schattenstrategie-collab/meridron-catalog-demo/pkg/00_START_HERE.pdf

## MERIDRON · BLUEPRINT CATALOG

# START HERE · D1b TRAINER

## REV 1 · 25 Oct 2026 · DESIGN CHECKED · FIRST FLIGHT PENDING

# THE FOUR STEPS (SAME FOR EVERY DRONE)

1
WATCH | 07_Video: the explainer, once, before you touch anything.
2 DOWNLOAD | You have it: this ZIP with seven folders.
3 BUILD | 05_Build_Guide: 14 steps, one page each, a check at the end of every step.
4 CHECK | Last page of the build guide: tick every box before the first flight.

# WHAT IS IN EACH FOLDER

Folder | What it is | Size
01_Cutting | Foam templates: 1:1 PDF on A4 + DXF for CNC/hot wire | 167 kB
02_Print | 16 STL files + print list. Print each file as often as its name says. | 1.6 MB
03_Wiring | Wiring diagram: battery, ESC, motor, receiver, 2 servos | 35 kB
04_Firmware_Radio | No flight controller on the D1b: radio setup sheet (channels, throws, failsafe) | 110 kB
05_Build_Guide | 14 steps with pictures, time and a pass check for each step | 1.6 MB
06_Parts_List | Everything to buy, with quantities and CHF prices | 2 kB
07_Video | Explainer video (works without sound) | 5.1 MB

# NAMES

Every file starts with the drone and revision: D1b_Rev1_…. Print files end with how often to print them: …_print-5x.stl = print 5.

## STATUS AND LICENCE

Calculated, not yet flown. Rev 1 becomes 'Flight proven' after the first build in the demonstrator workshop. Report anything that does not fit: every report makes the next revision. This package is for authorized Meridron partners only. Do not pass it on.

Meridron · D1b Trainer Rev 1 · 25 Oct 2026 · Start here | 1
