schattenstrategie-collab/meridron-catalog-demo/pkg/01_Cutting/D1b_Rev1_Templates_1to1_A4.pdf

# D1b TRAINER · FOAM TEMPLATES 1:1

1 Print this file at 100 % (actual size). Never 'fit to page'.
2 Measure the 50 mm bar on every page and the 100 mm square below.
3 Tape the pages of one part together: grey band = overlap, line up the crosses.
4 Cut the paper on the thick line. Trace it onto the foam. Dashed lines are marks, not cuts.
5 Orange = cut-outs (servo window, horn slits, dowel holes).
Part | Name | Material | Cut | Pages
F1 | Fuselage core | XPS 30 mm | 1 × | 2–4
F2 | Fuselage side wall | Depron 6 mm | 2 × | 5–7
T1 | Stabilizer + elevator | Depron 6 mm | 1 × | 8–9
T2 | Fin + rudder | Depron 6 mm | 1 × | 10
S1 | Top skin, centre | Depron 3 mm | 1 × | 11–13
S2 | Top skin, outer panel + tip | Depron 3 mm | 2 × | 14–16
S3 | Bottom skin, centre | Depron 3 mm | 1 × | 17–18
S4 | Bottom skin, outer panel | Depron 3 mm | 2 × | 19–20

100 × 100 mm
measure both sides

50 mm check: must measure exactly 50 mm

Status: Design checked · first flight pending. Calculated, not yet flown.

Meridron · D1b Trainer Rev 1 · Foam templates 1:1 · Cover | Page 1 of 20

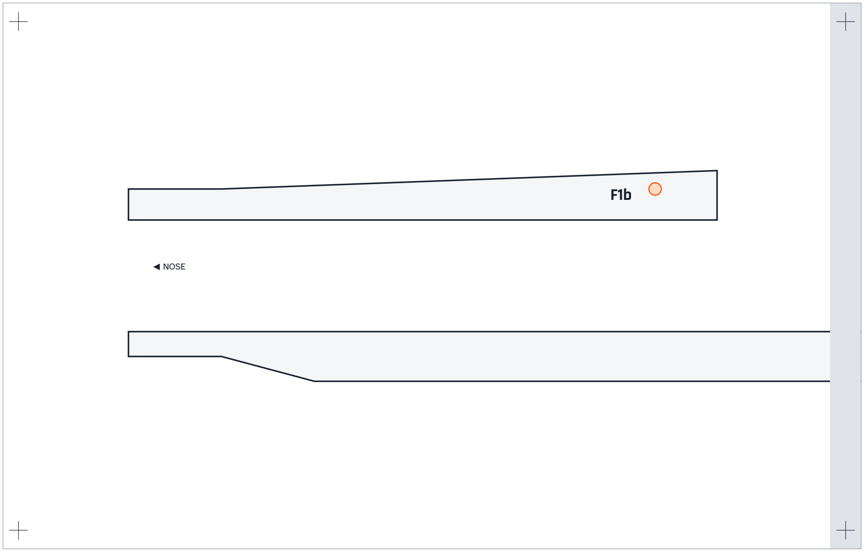
[picture p1: figure]
NOSE

50 mm check: must measure exactly 50 mm | F1 1/3 Saw outside the line · F1b = tunnel roof (separate piece)
Drill dowel holes after gluing (Ø 4)
Meridron · D1b Trainer Rev 1 · Foam templates 1:1 · F1 Fuselage core | Page 2 of 20

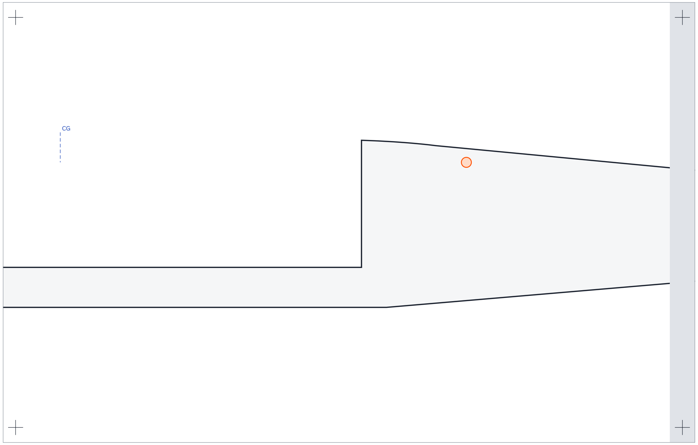
[picture p2: figure]

50 mm check: must measure exactly 50 mm | F1 2/3 Saw outside the line · F1b = tunnel roof (separate piece)
Drill dowel holes after gluing (Ø 4)
Meridron · D1b Trainer Rev 1 · Foam templates 1:1 · F1 Fuselage core | Page 3 of 20

F1a

Fuselage core · XPS 30 mm · cut 1

50 mm check: must measure exactly 50 mm | F1 3/3 Saw outside the line · F1b = tunnel roof (separate piece)
Drill dowel holes after gluing (Ø 4)
Meridron · D1b Trainer Rev 1 · Foam templates 1:1 · F1 Fuselage core | Page 4 of 20

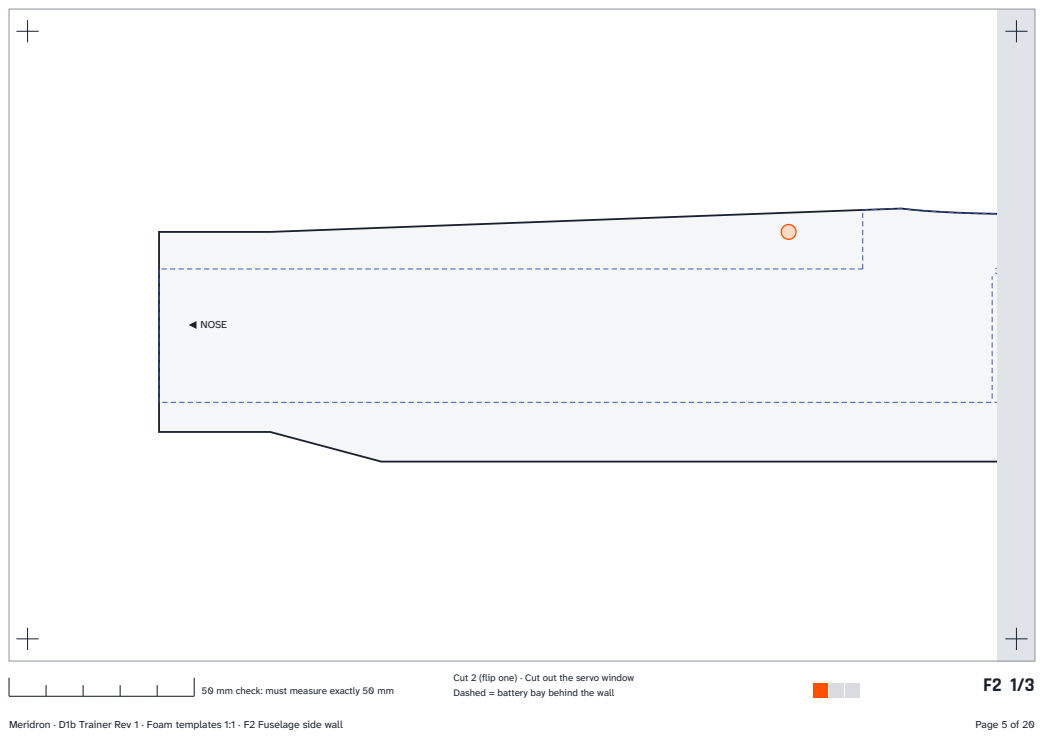
[picture p3: page 5]
3S 2200 front; NOSE; 50 mm check: must measure exactly 50 mm; F2 1/3 Cut 2 (flip one) · Cut out the servo window; Meridron · D1b Trainer Rev 1 · Foam templates 1:1 · F2 Fuselage side wall; Page 5 of 20

Dashed = battery bay behind the wall

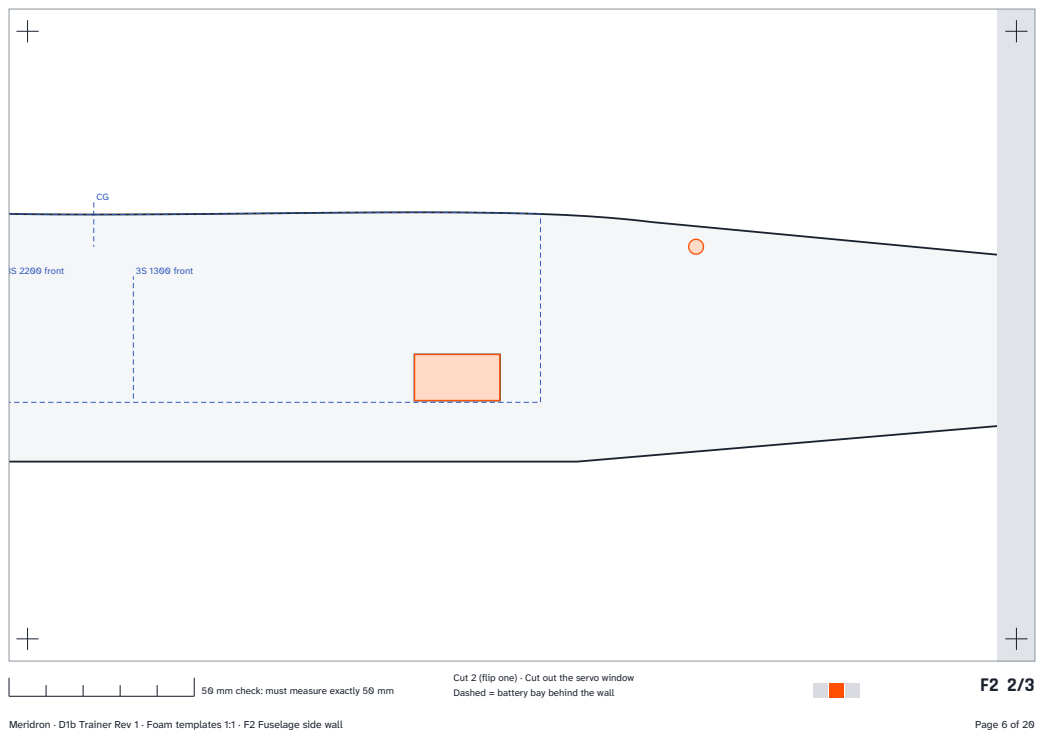
[picture p4: page 6]
3S 2200 front; 3S 1300 front; 50 mm check: must measure exactly 50 mm; F2 2/3 Cut 2 (flip one) · Cut out the servo window; Meridron · D1b Trainer Rev 1 · Foam templates 1:1 · F2 Fuselage side wall; Page 6 of 20

Dashed = battery bay behind the wall

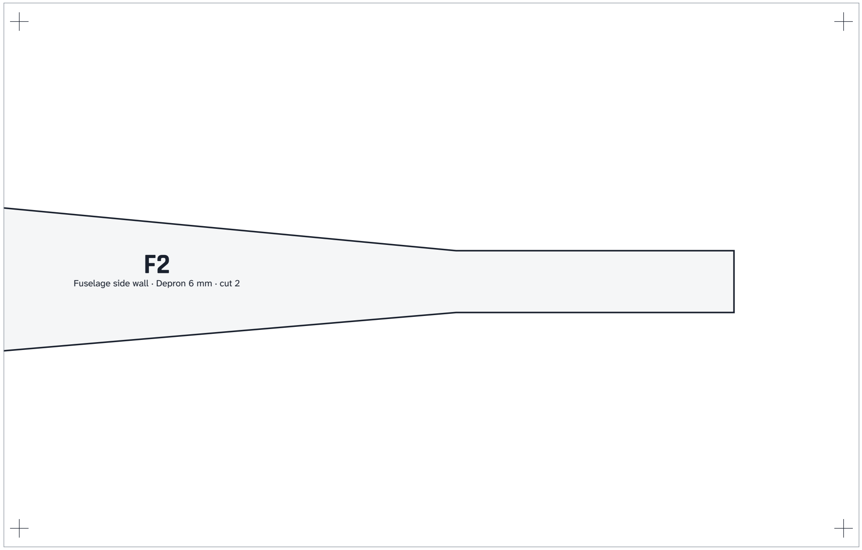
[picture p5: figure]

Fuselage side wall · Depron 6 mm · cut 2

50 mm check: must measure exactly 50 mm | F2 3/3 Cut 2 (flip one) · Cut out the servo window
Dashed = battery bay behind the wall
Meridron · D1b Trainer Rev 1 · Foam templates 1:1 · F2 Fuselage side wall | Page 7 of 20

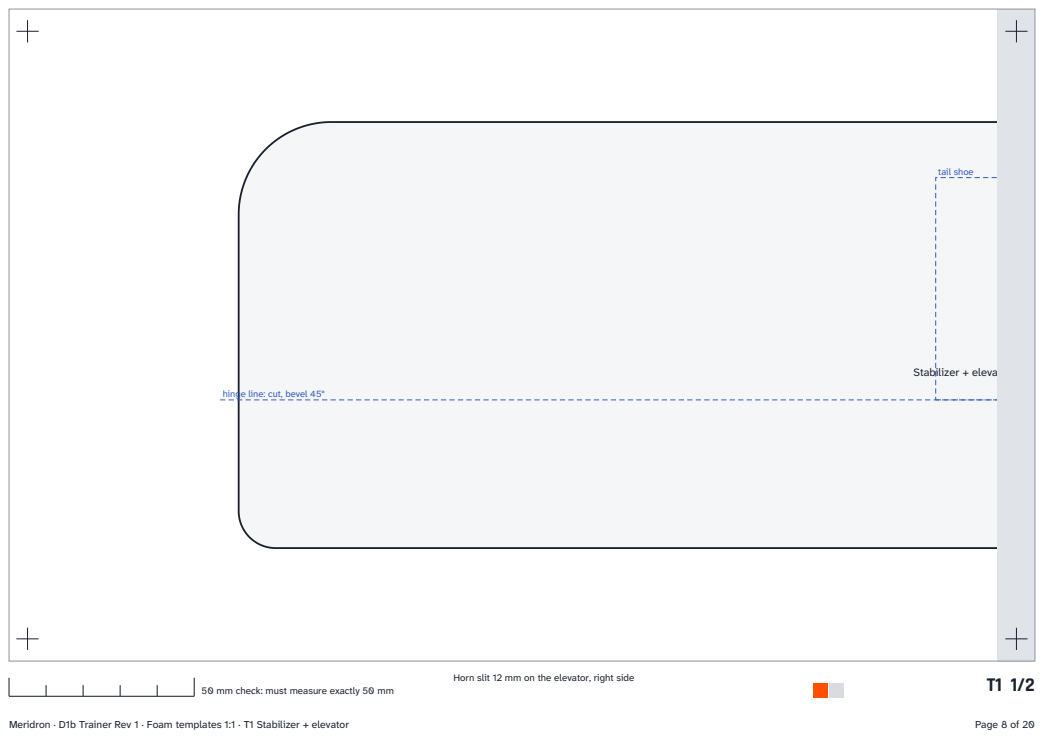
[picture p6: page 8]
tail shoe; 50 mm check: must measure exactly 50 mm; T1 1/2 Horn slit 12 mm on the elevator, right side; Meridron · D1b Trainer Rev 1 · Foam templates 1:1 · T1 Stabilizer + elevator; Page 8 of 20

Stabilizer + elevator · Depron 6 mm · cut 1

hinge line: cut, bevel 45°

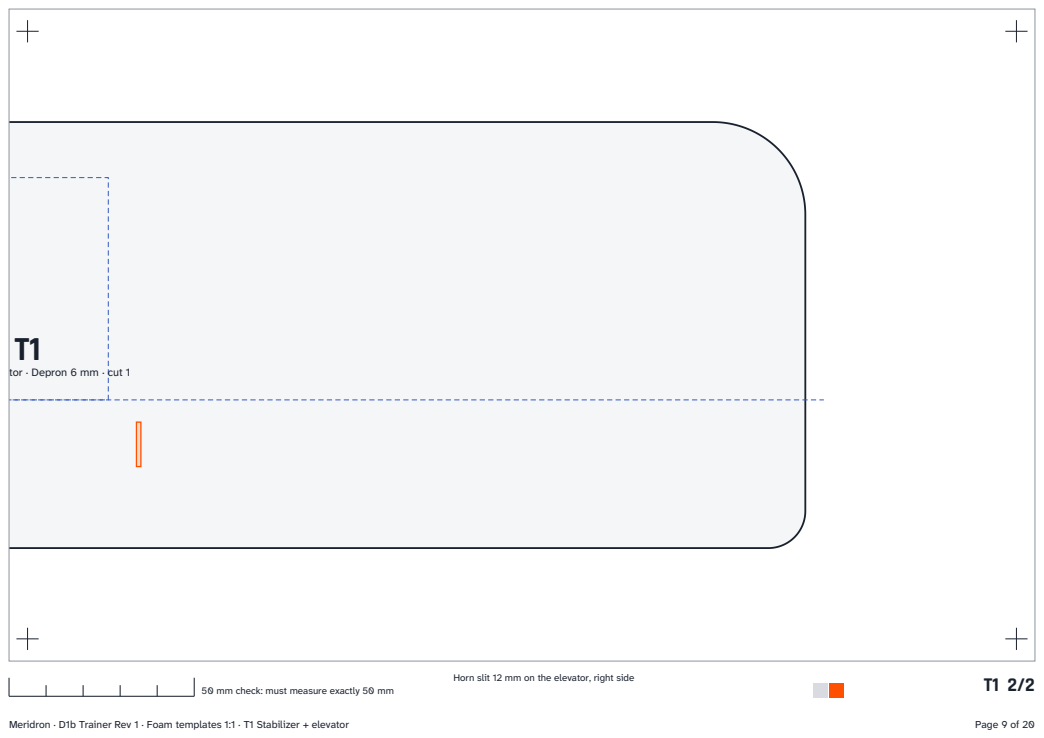
[picture p7: page 9]
tail shoe; 50 mm check: must measure exactly 50 mm; T1 2/2 Horn slit 12 mm on the elevator, right side; Meridron · D1b Trainer Rev 1 · Foam templates 1:1 · T1 Stabilizer + elevator; Page 9 of 20

Stabilizer + elevator · Depron 6 mm · cut 1

hinge line: cut, bevel 45° | below: 10 mm into the shoe slot
T2

Fin + rudder · Depron 6 mm · cut 1

50 mm check: must measure exactly 50 mm | T2 1/1 Horn slit on the rudder, left side
Meridron · D1b Trainer Rev 1 · Foam templates 1:1 · T2 Fin + rudder | Page 10 of 20

spar line (30 %)

50 mm check: must measure exactly 50 mm | S1 1/3 Dashed lines = ribs (glue lines)
Meridron · D1b Trainer Rev 1 · Foam templates 1:1 · S1 Top skin, centre | Page 11 of 20

FRONT EDGE: butts against the rib noses

S1

Top skin, centre · Depron 3 mm · cut 1

50 mm check: must measure exactly 50 mm | S1 2/3 Dashed lines = ribs (glue lines)
Meridron · D1b Trainer Rev 1 · Foam templates 1:1 · S1 Top skin, centre | Page 12 of 20

50 mm check: must measure exactly 50 mm | S1 3/3 Dashed lines = ribs (glue lines)
Meridron · D1b Trainer Rev 1 · Foam templates 1:1 · S1 Top skin, centre | Page 13 of 20

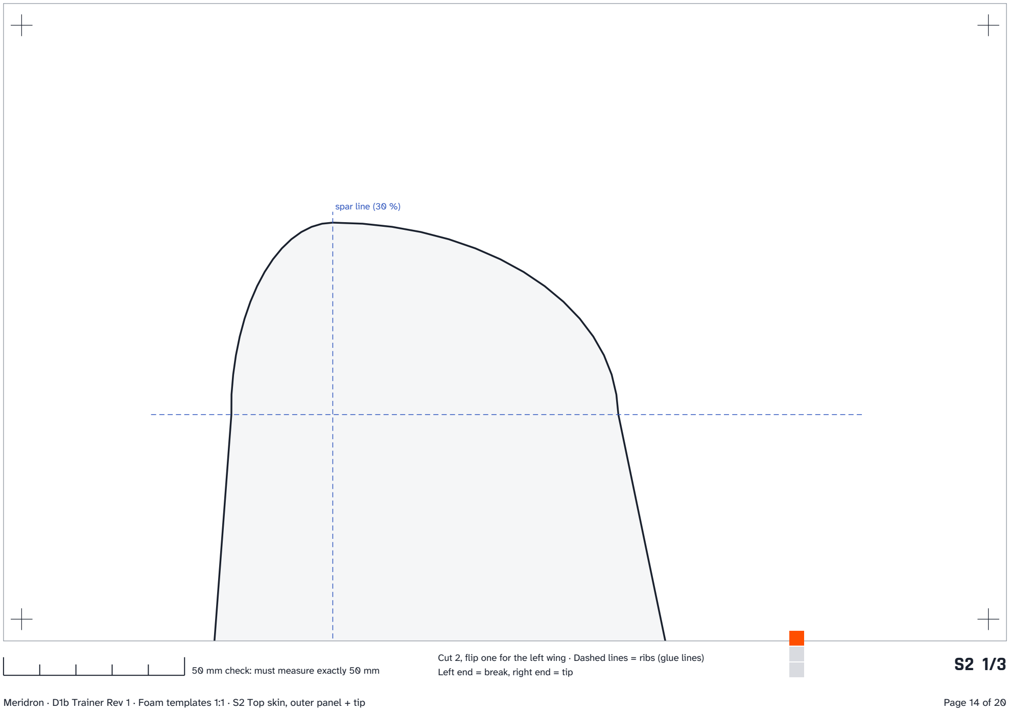
[picture p8: figure]
spar line (30 %); Left end = break, right end = tip

50 mm check: must measure exactly 50 mm | S2 1/3 Cut 2, flip one for the left wing · Dashed lines = ribs (glue lines)
Meridron · D1b Trainer Rev 1 · Foam templates 1:1 · S2 Top skin, outer panel + tip | Page 14 of 20

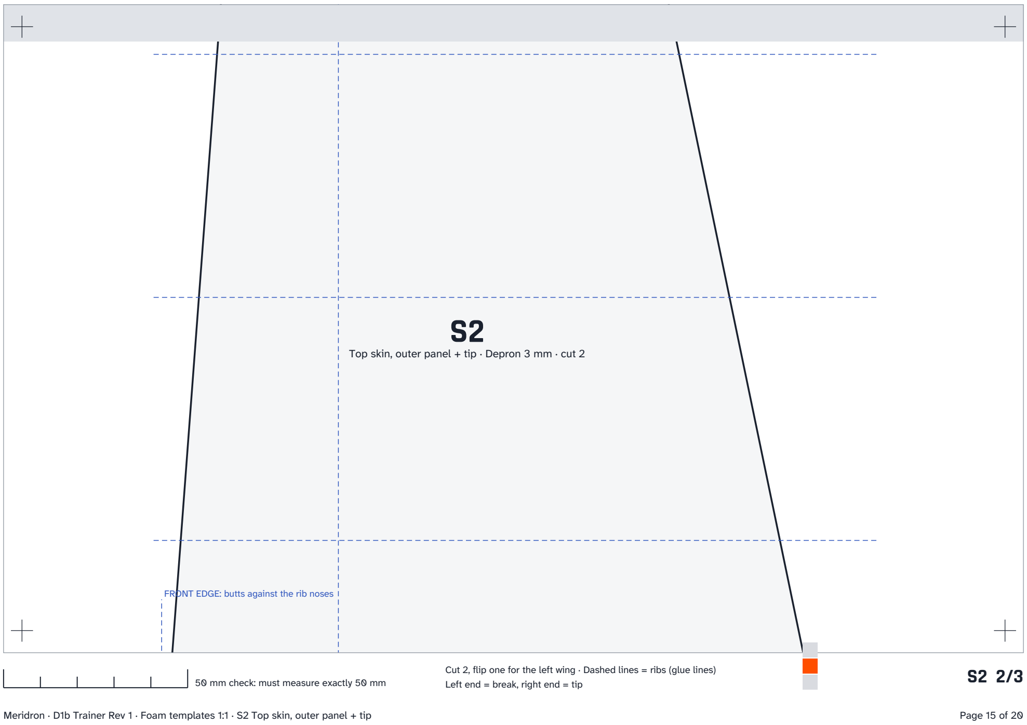
[picture p9: figure]
FRONT EDGE: butts against the rib noses; Left end = break, right end = tip

Top skin, outer panel + tip · Depron 3 mm · cut 2

50 mm check: must measure exactly 50 mm | S2 2/3 Cut 2, flip one for the left wing · Dashed lines = ribs (glue lines)
Meridron · D1b Trainer Rev 1 · Foam templates 1:1 · S2 Top skin, outer panel + tip | Page 15 of 20

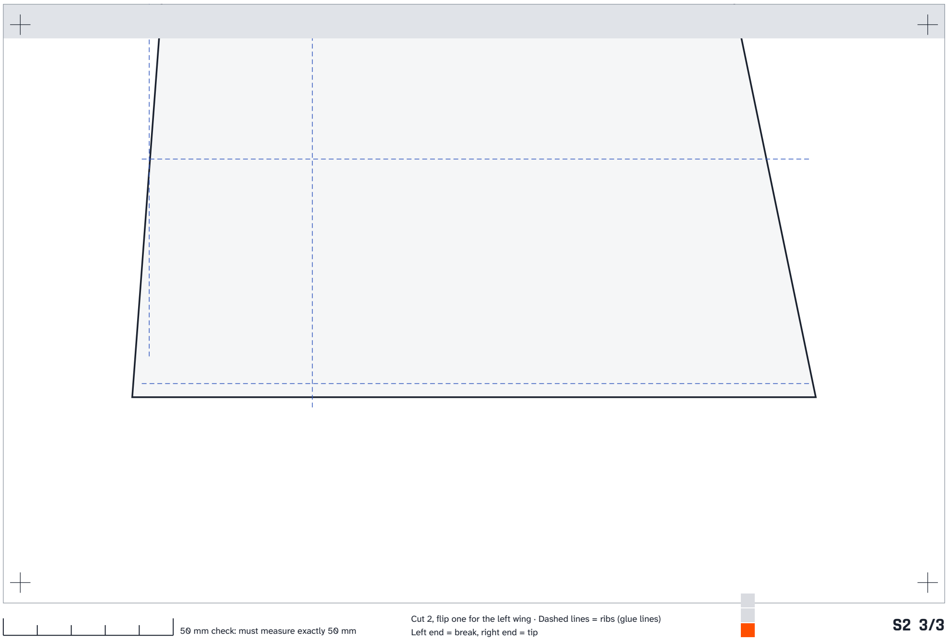
[picture p10: figure]
Left end = break, right end = tip

50 mm check: must measure exactly 50 mm | S2 3/3 Cut 2, flip one for the left wing · Dashed lines = ribs (glue lines)
Meridron · D1b Trainer Rev 1 · Foam templates 1:1 · S2 Top skin, outer panel + tip | Page 16 of 20

spar line (30 %)

FRONT EDGE: butts against the rib noses

S3

Bottom skin, centre · Depron 3 mm · cut 1

50 mm check: must measure exactly 50 mm | S3 1/2 Dashed lines = ribs (glue lines)
Meridron · D1b Trainer Rev 1 · Foam templates 1:1 · S3 Bottom skin, centre | Page 17 of 20

S3

Bottom skin, centre · Depron 3 mm · cut 1

50 mm check: must measure exactly 50 mm | S3 2/2 Dashed lines = ribs (glue lines)
Meridron · D1b Trainer Rev 1 · Foam templates 1:1 · S3 Bottom skin, centre | Page 18 of 20

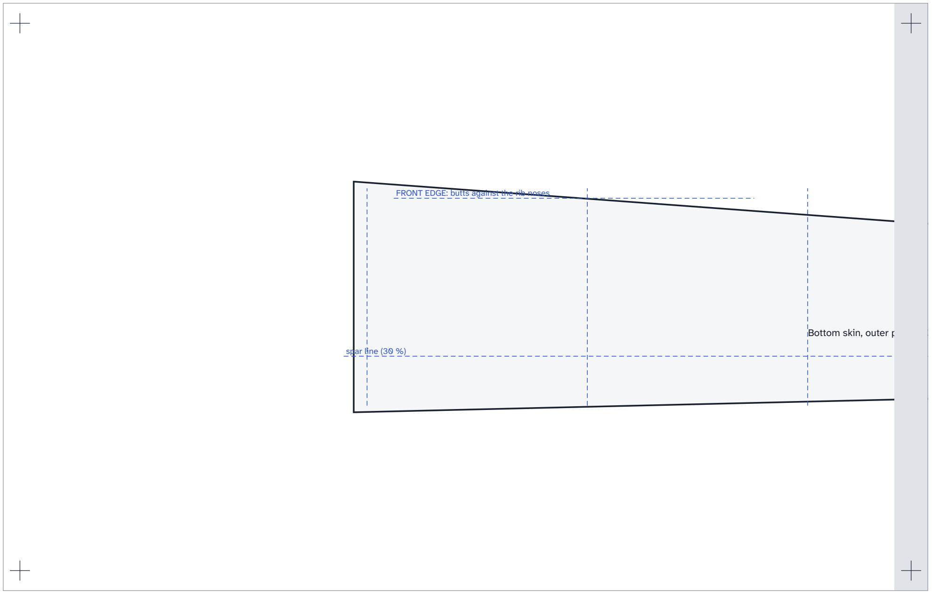
[picture p11: figure]
spar line (30 %); FRONT EDGE: butts against the rib noses

Bottom skin, outer panel · Depron 3 mm · cut 2

50 mm check: must measure exactly 50 mm | S4 1/2 Cut 2, flip one for the left wing · Dashed lines = ribs (glue lines)
Left end = break, right end = tip
Meridron · D1b Trainer Rev 1 · Foam templates 1:1 · S4 Bottom skin, outer panel | Page 19 of 20

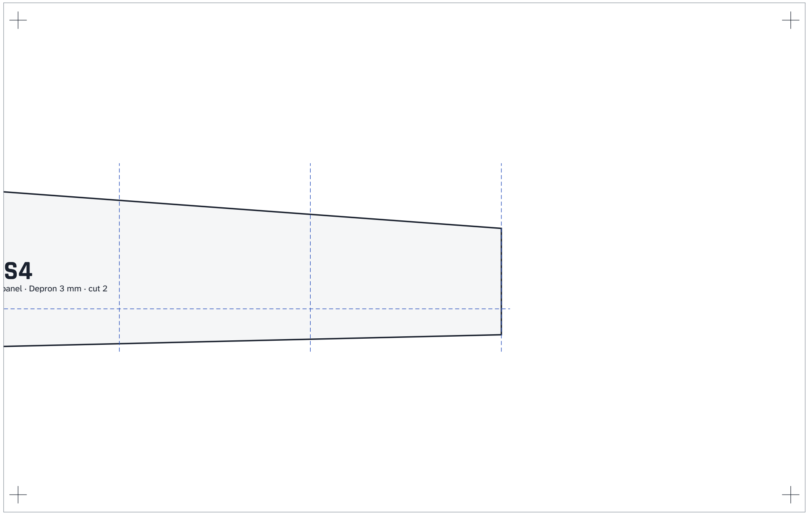
[picture p12: figure]

Bottom skin, outer panel · Depron 3 mm · cut 2

50 mm check: must measure exactly 50 mm | S4 2/2 Cut 2, flip one for the left wing · Dashed lines = ribs (glue lines)
Left end = break, right end = tip
Meridron · D1b Trainer Rev 1 · Foam templates 1:1 · S4 Bottom skin, outer panel | Page 20 of 20
