schattenstrategie-collab/meridron-catalog-demo/media/hero.webp

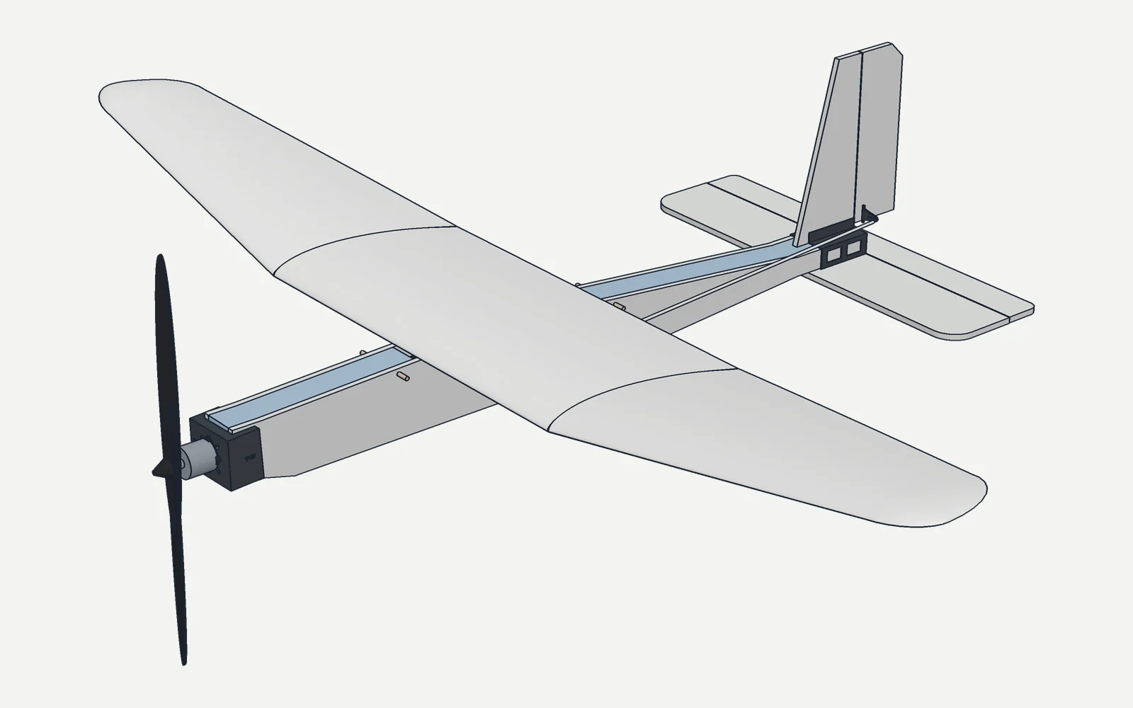
media/hero.webp
