schattenstrategie-collab/meridron-catalog-demo/media/poster.jpg

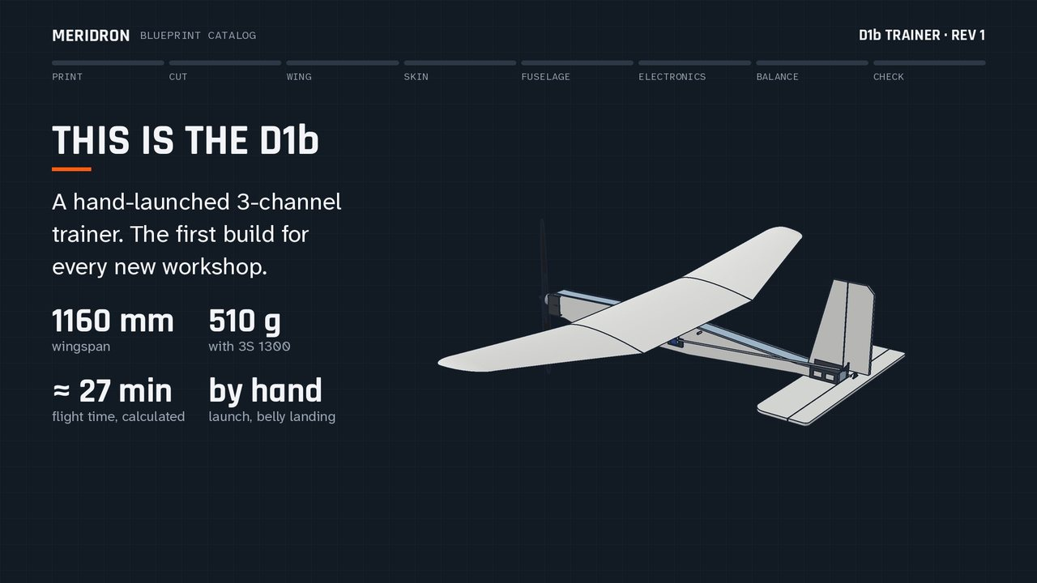
media/poster.jpg
