schattenstrategie-collab/meridron-catalog-demo/media/promo_poster.jpg

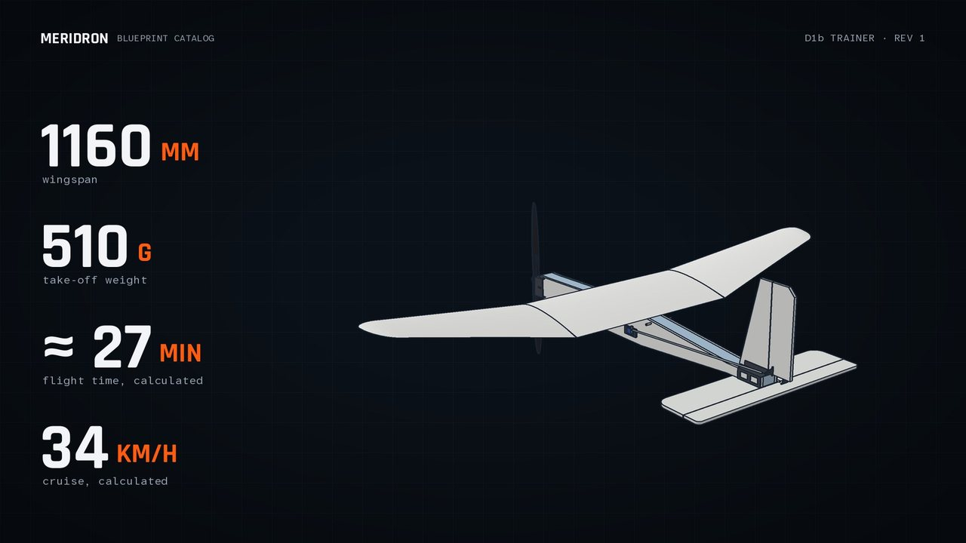
media/promo_poster.jpg
