schattenstrategie-collab/meridron-catalog-demo/media/s02_templates.webp

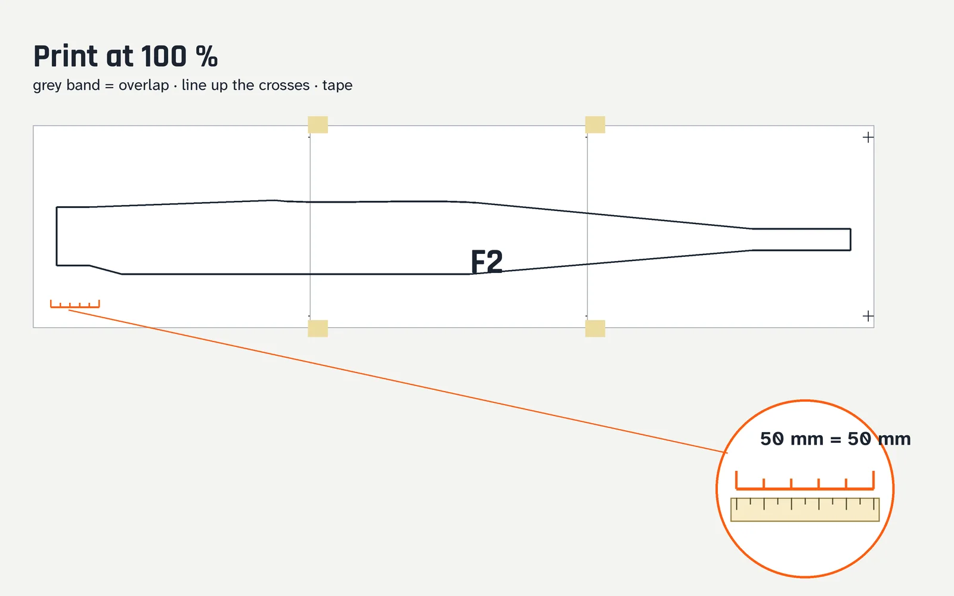
media/s02_templates.webp
