schattenstrategie-collab/meridron-catalog-demo/media/s03_core.webp

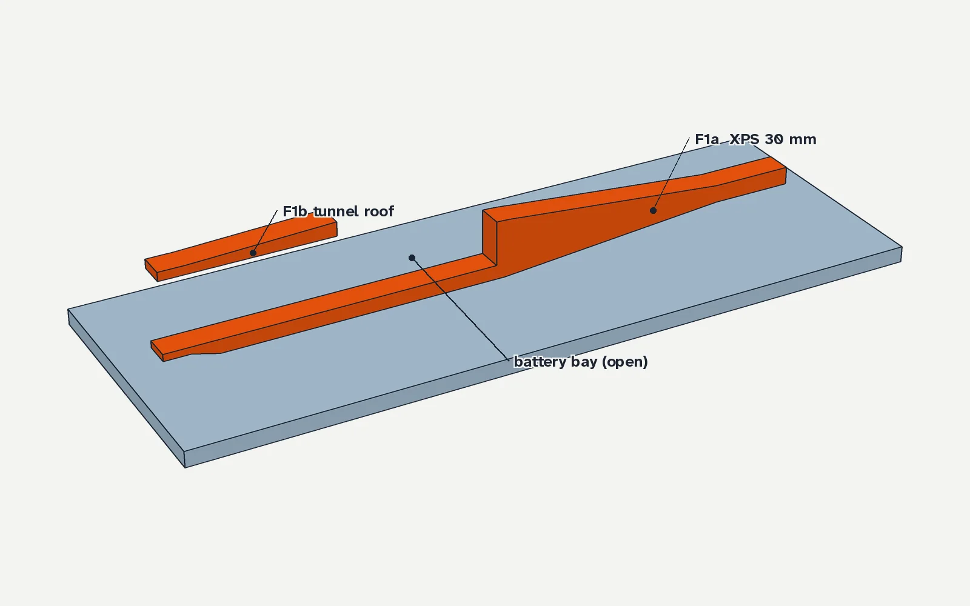
media/s03_core.webp
