schattenstrategie-collab/meridron-catalog-demo/media/s04_depron.webp

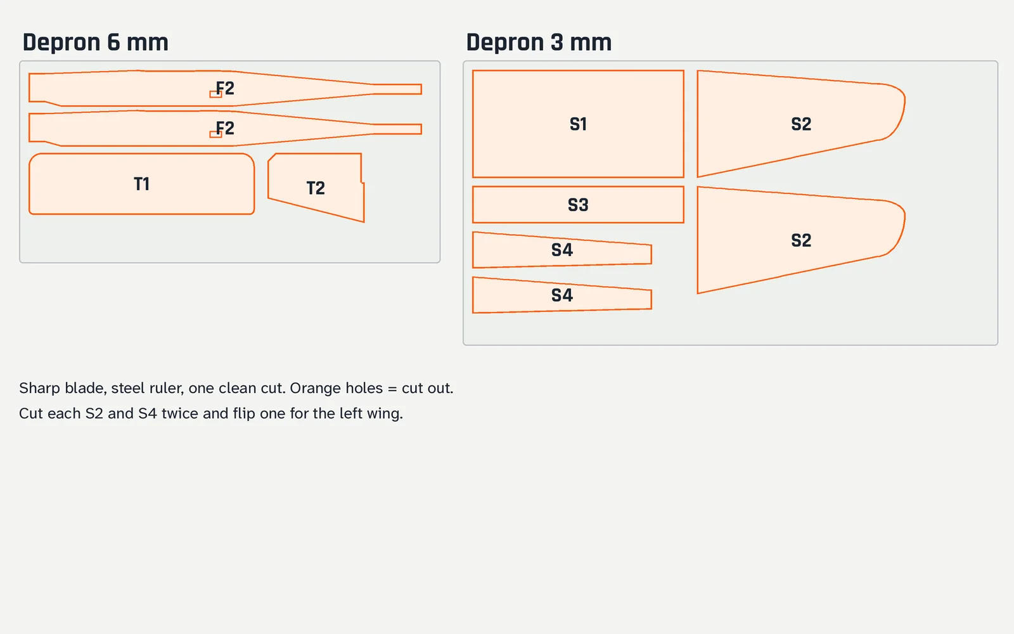
media/s04_depron.webp
