schattenstrategie-collab/meridron-catalog-demo/media/s05_centre.webp

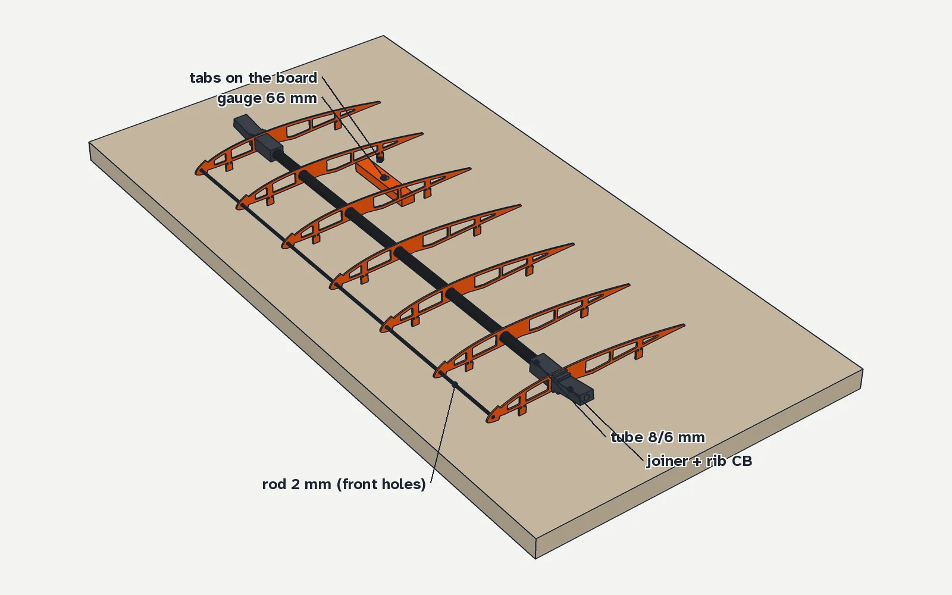
media/s05_centre.webp
