schattenstrategie-collab/meridron-catalog-demo/media/s06_outer.webp

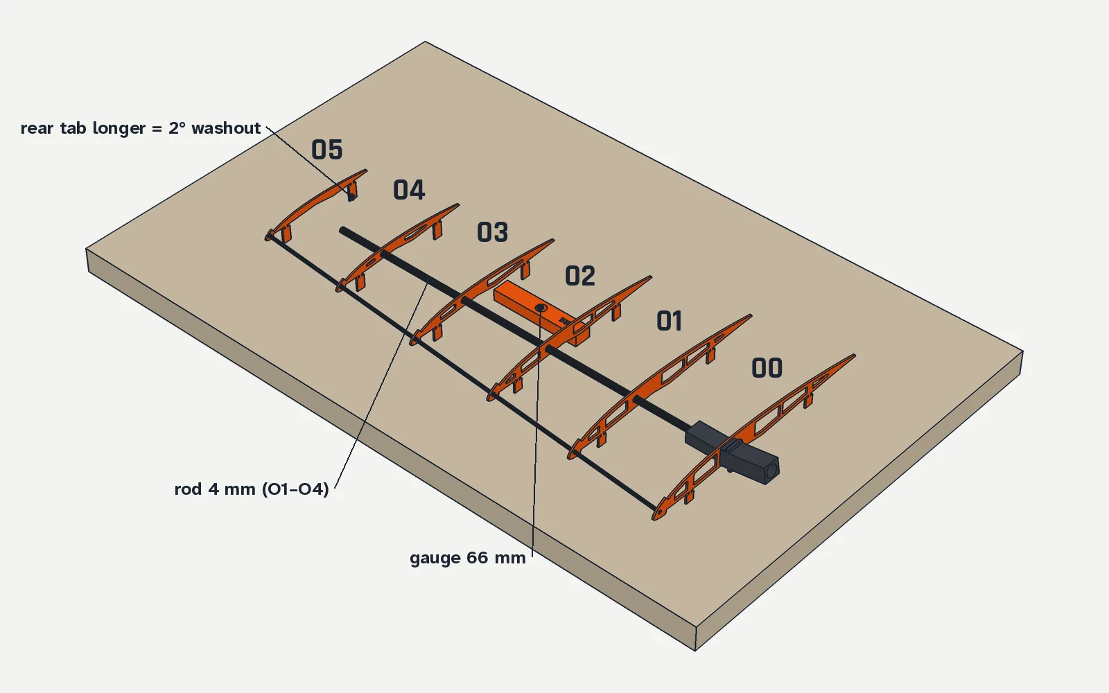
media/s06_outer.webp
