schattenstrategie-collab/meridron-catalog-demo/media/s08_join.webp

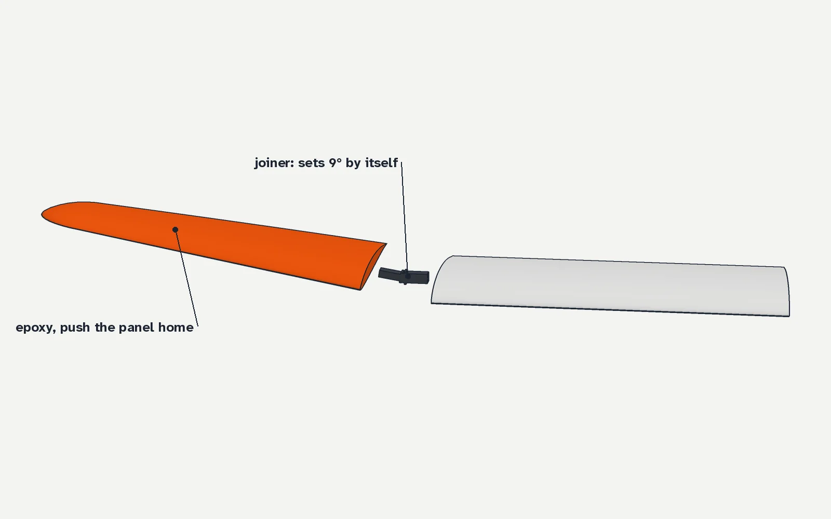
media/s08_join.webp
