schattenstrategie-collab/meridron-catalog-demo/media/s09_film.webp

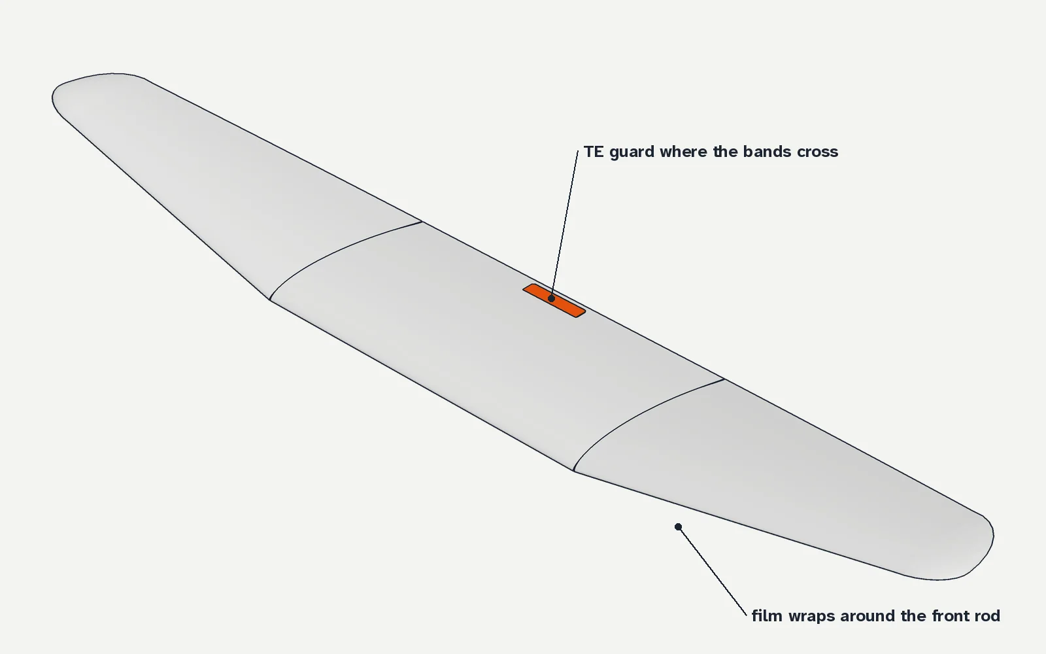
media/s09_film.webp
