schattenstrategie-collab/meridron-catalog-demo/media/s10_fuselage.webp

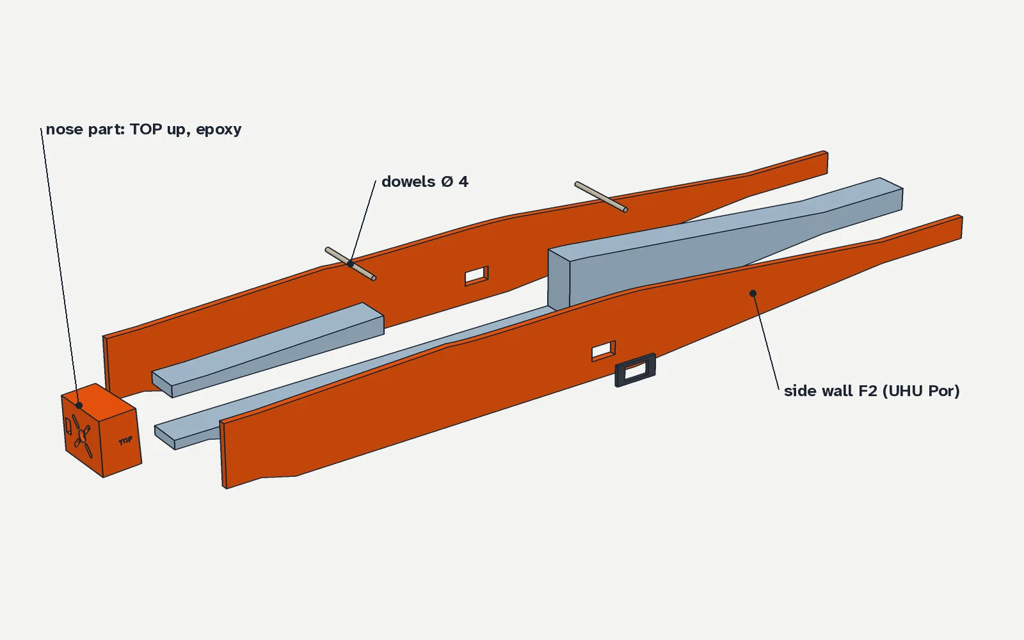
media/s10_fuselage.webp
