schattenstrategie-collab/meridron-catalog-demo/media/s11_tail.webp

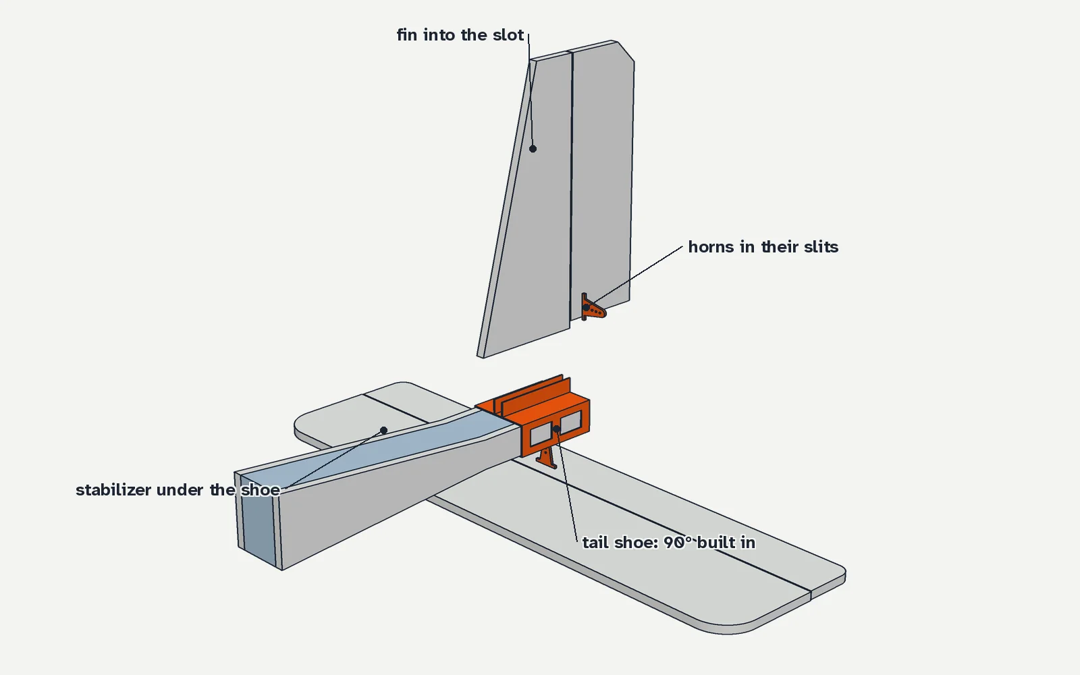
media/s11_tail.webp
