schattenstrategie-collab/meridron-catalog-demo/media/s12_electronics.webp

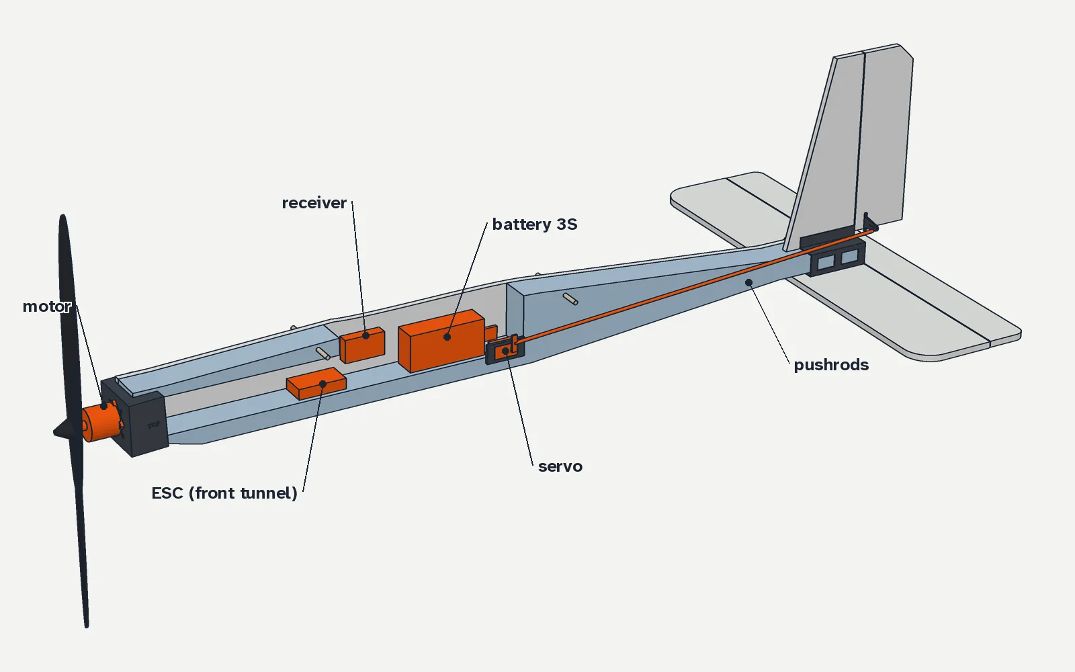
media/s12_electronics.webp
