schattenstrategie-collab/meridron-catalog-demo/media/s13_radio.webp

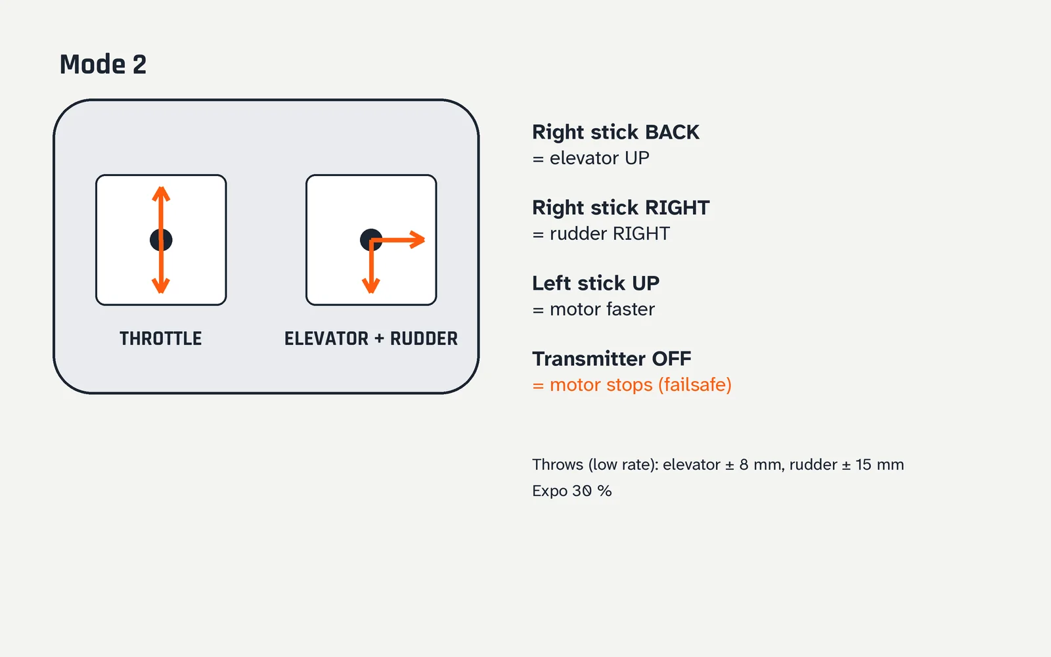
media/s13_radio.webp
