schattenstrategie-collab/meridron-catalog-demo/media/s14_balance.webp

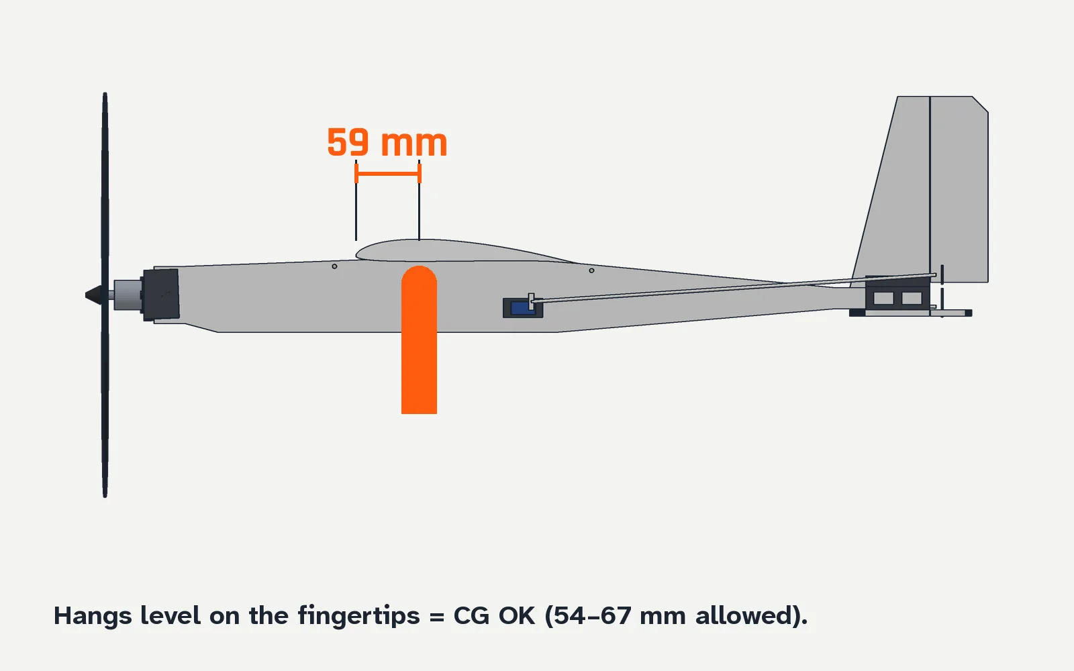
media/s14_balance.webp
