schattenstrategie-collab/meridron-catalog-demo/media/three_view.webp

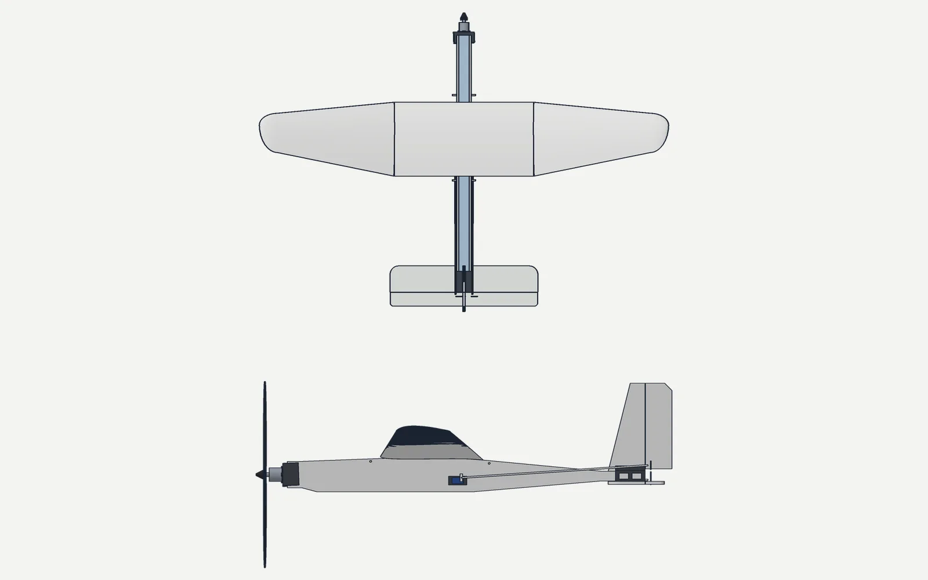
media/three_view.webp
