schattenstrategie-collab/meridron-catalog-demo/pkg/01_Cutting/D1b_Rev1_Templates.dxf

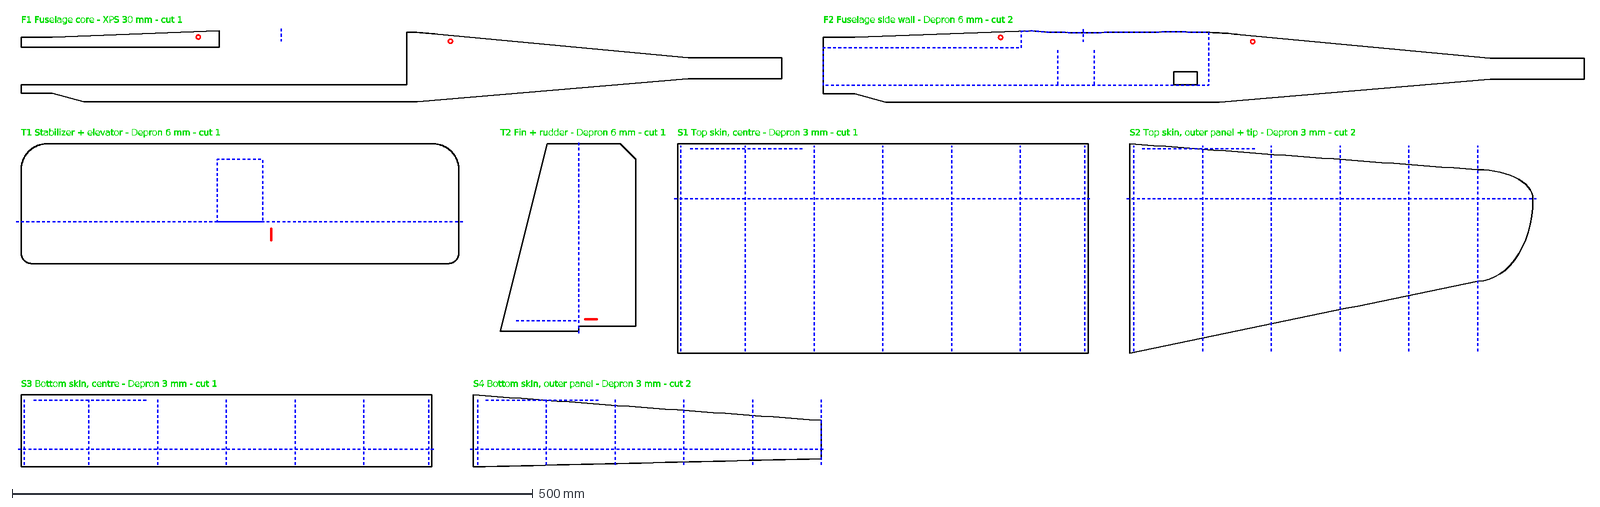
[picture p29: CAD file, 2026-10-25]
pkg/01_Cutting/D1b_Rev1_Templates.dxf
F1 Fuselage core - XPS 30 mm - cut 1
F2 Fuselage side wall - Depron 6 mm - cut 2
T1 Stabilizer + elevator - Depron 6 mm - cut 1
T2 Fin + rudder - Depron 6 mm - cut 1
S1 Top skin, centre - Depron 3 mm - cut 1
S2 Top skin, outer panel + tip - Depron 3 mm - cut 2
S3 Bottom skin, centre - Depron 3 mm - cut 1
S4 Bottom skin, outer panel - Depron 3 mm - cut 2
