schattenstrategie-collab/meridron-catalog-demo/pkg/02_Print/D1b_Rev1_W2-07_Outer-Rib-O4_print-2x.stl

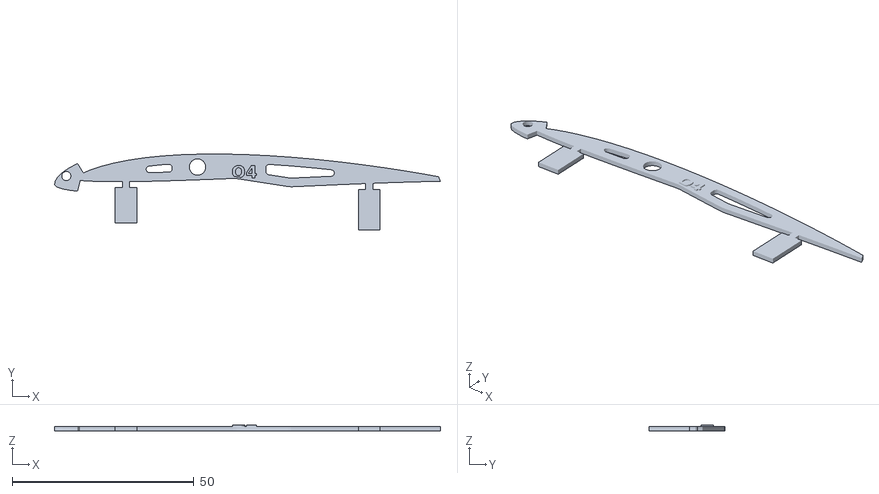
[picture p30: CAD file, 2026-10-25]
pkg/02_Print/D1b_Rev1_W2-07_Outer-Rib-O4_print-2x.stl
106.3 x 20.9 x 1.59
