schattenstrategie-collab/meridron-catalog-demo/pkg/02_Print/D1b_Rev1_D1-02_Servo-Frame_print-2x.stl

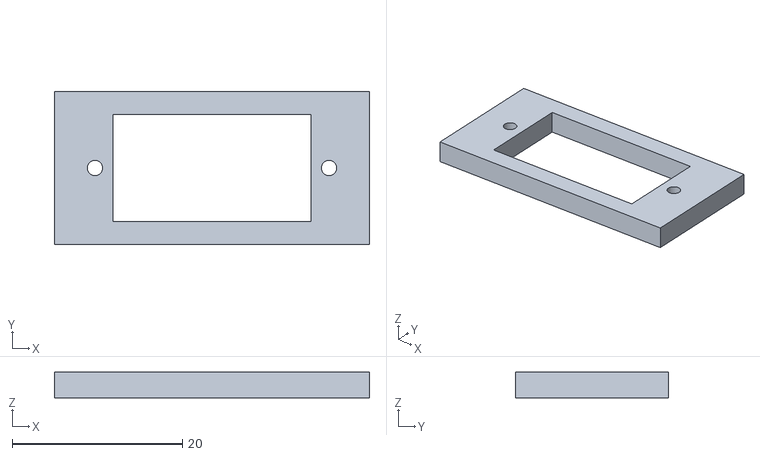
[picture p31: CAD file, 2026-10-25]
pkg/02_Print/D1b_Rev1_D1-02_Servo-Frame_print-2x.stl
37.0 x 18.0 x 3.00
