schattenstrategie-collab/meridron-catalog-demo/pkg/02_Print/D1b_Rev1_W2-01_Centre-Rib_print-5x.stl

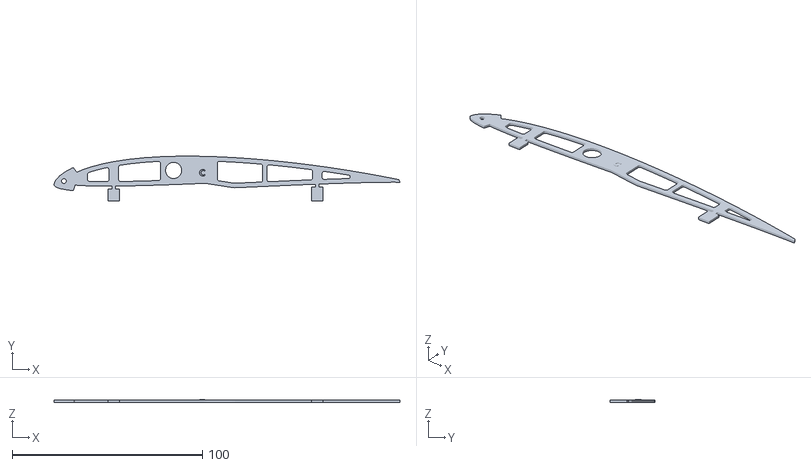
[picture p32: CAD file, 2026-10-25]
pkg/02_Print/D1b_Rev1_W2-01_Centre-Rib_print-5x.stl
182.1 x 23.5 x 1.59
