schattenstrategie-collab/meridron-catalog-demo/pkg/02_Print/D1b_Rev1_W2-10_TE-Guard_print-1x.stl

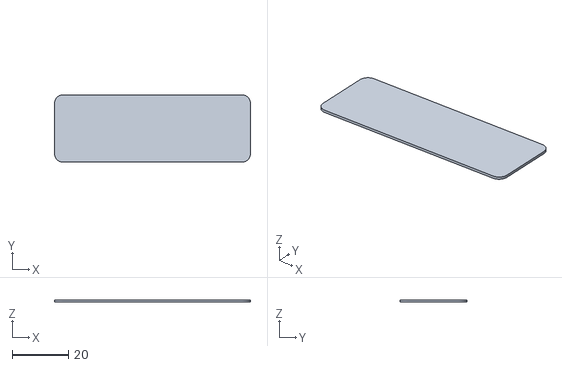
[picture p33: CAD file, 2026-10-25]
pkg/02_Print/D1b_Rev1_W2-10_TE-Guard_print-1x.stl
70.0 x 24.0 x 0.8
