schattenstrategie-collab/meridron-catalog-demo/pkg/02_Print/D1b_Rev1_D1-01_Nose-Motor-Mount_print-1x.stl

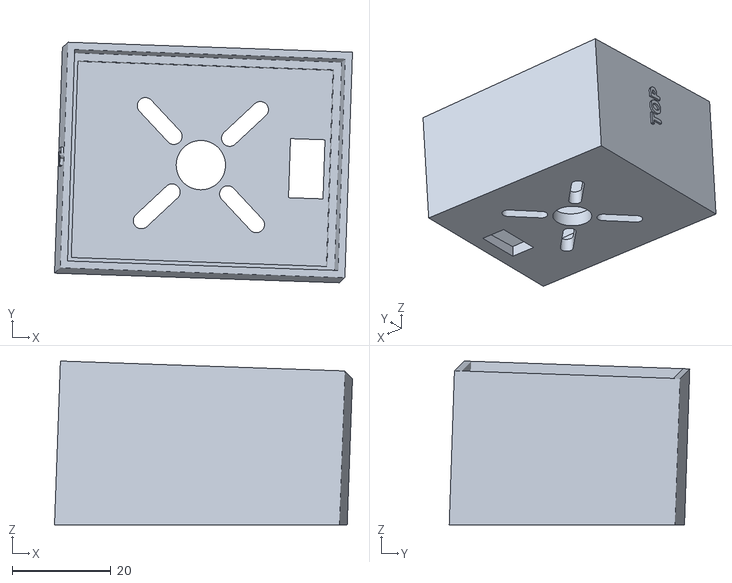
[picture p34: CAD file, 2026-10-25]
pkg/02_Print/D1b_Rev1_D1-01_Nose-Motor-Mount_print-1x.stl
60.5 x 48.8 x 33.3
