schattenstrategie-collab/meridron-catalog-demo/pkg/02_Print/D1b_Rev1_W2-08_Outer-Rib-O5_print-2x.stl

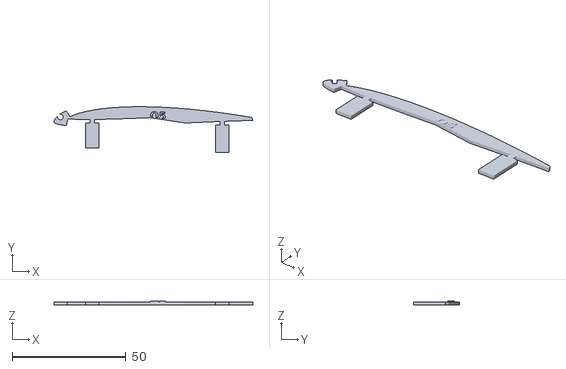
[picture p35: CAD file, 2026-10-25]
pkg/02_Print/D1b_Rev1_W2-08_Outer-Rib-O5_print-2x.stl
87.4 x 20.0 x 1.59
