schattenstrategie-collab/meridron-catalog-demo/pkg/02_Print/D1b_Rev1_D1-04_Bowden-Clip_print-6x.stl

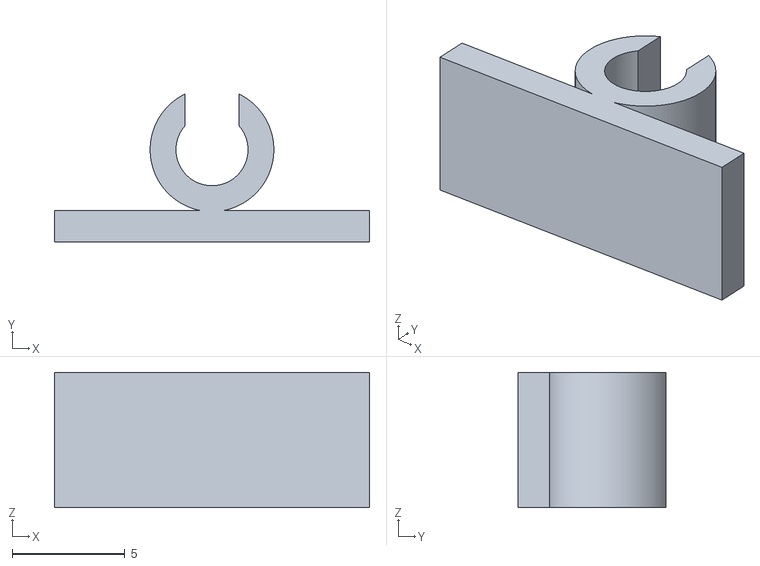
[picture p36: CAD file, 2026-10-25]
pkg/02_Print/D1b_Rev1_D1-04_Bowden-Clip_print-6x.stl
14.0 x 6.57 x 6.00
