schattenstrategie-collab/meridron-catalog-demo/pkg/02_Print/D1b_Rev1_W2-09_Dihedral-Joiner_print-2x.stl

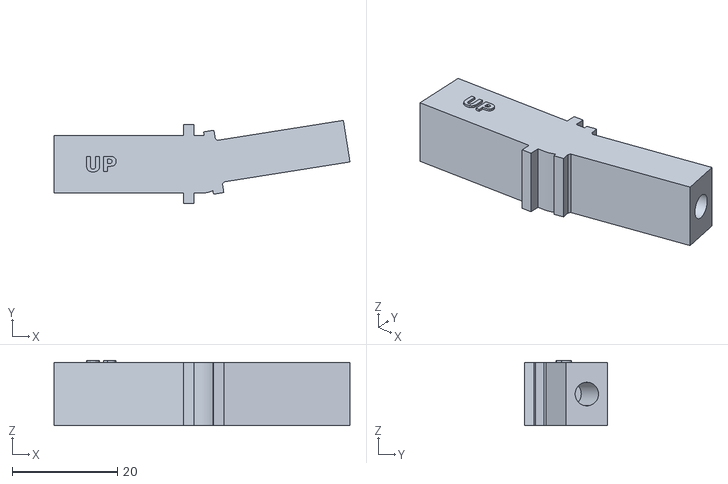
[picture p37: CAD file, 2026-10-25]
pkg/02_Print/D1b_Rev1_W2-09_Dihedral-Joiner_print-2x.stl
56.3 x 15.8 x 12.4
