schattenstrategie-collab/meridron-catalog-demo/pkg/02_Print/D1b_Rev1_W2-06_Outer-Rib-O3_print-2x.stl

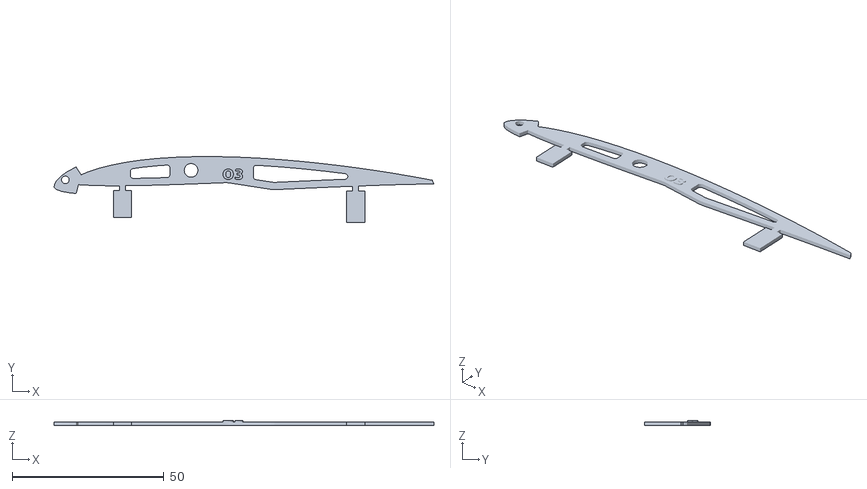
[picture p39: CAD file, 2026-10-25]
pkg/02_Print/D1b_Rev1_W2-06_Outer-Rib-O3_print-2x.stl
125.3 x 21.7 x 1.59
