schattenstrategie-collab/meridron-catalog-demo/pkg/02_Print/D1b_Rev1_W2-02_Centre-Break-Rib_print-2x.stl

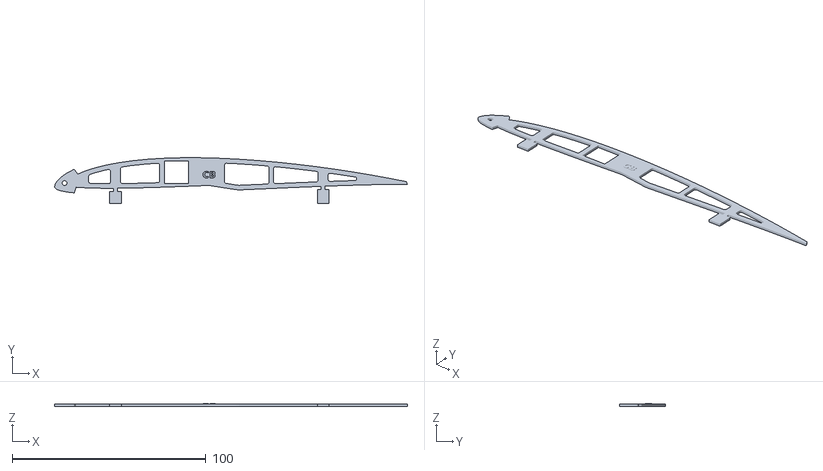
[picture p40: CAD file, 2026-10-25]
pkg/02_Print/D1b_Rev1_W2-02_Centre-Break-Rib_print-2x.stl
182.1 x 23.5 x 1.59
