schattenstrategie-collab/meridron-catalog-demo/pkg/02_Print/D1b_Rev1_W2-05_Outer-Rib-O2_print-2x.stl

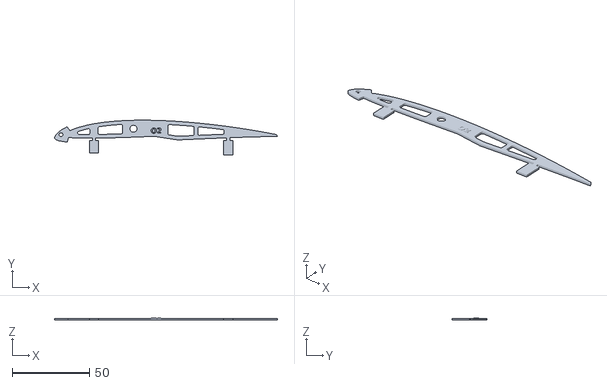
[picture p41: CAD file, 2026-10-25]
pkg/02_Print/D1b_Rev1_W2-05_Outer-Rib-O2_print-2x.stl
144.1 x 22.4 x 1.59
