schattenstrategie-collab/meridron-catalog-demo/pkg/02_Print/D1b_Rev1_W2-11_Rib-Spacing-Gauge_print-1x.stl

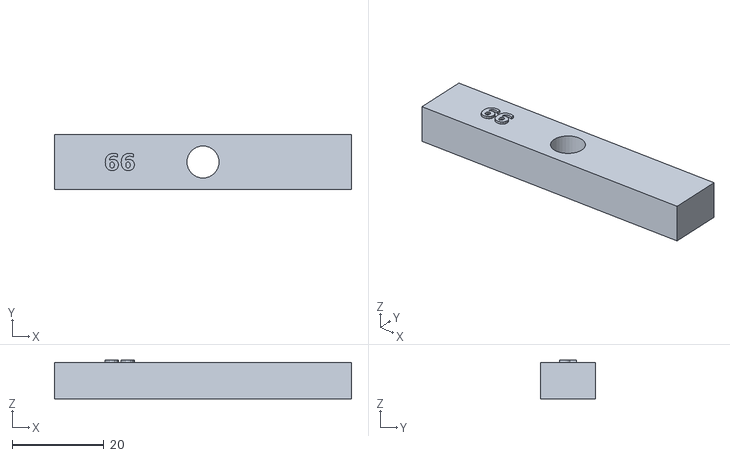
[picture p42: CAD file, 2026-10-25]
pkg/02_Print/D1b_Rev1_W2-11_Rib-Spacing-Gauge_print-1x.stl
64.8 x 12.0 x 8.49
