schattenstrategie-collab/meridron-catalog-demo/pkg/02_Print/D1b_Rev1_W2-04_Outer-Rib-O1_print-2x.stl

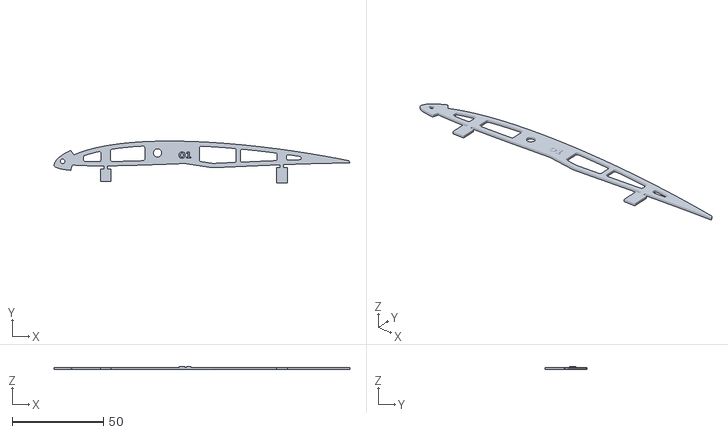
[picture p43: CAD file, 2026-10-25]
pkg/02_Print/D1b_Rev1_W2-04_Outer-Rib-O1_print-2x.stl
162.4 x 23.0 x 1.59
