schattenstrategie-collab/meridron-catalog-demo/pkg/02_Print/D1b_Rev1_D1-05_Tail-Shoe_print-1x.stl

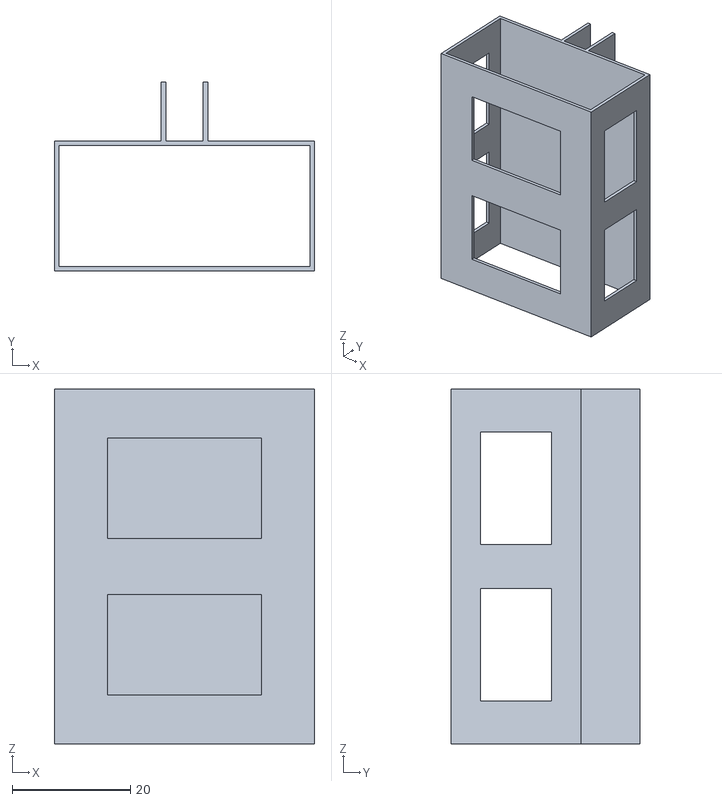
[picture p44: CAD file, 2026-10-25]
pkg/02_Print/D1b_Rev1_D1-05_Tail-Shoe_print-1x.stl
44.0 x 32.0 x 60.0
