schattenstrategie-collab/meridron-catalog-demo/pkg/02_Print/D1b_Rev1_D1-03_Control-Horn_print-3x.stl

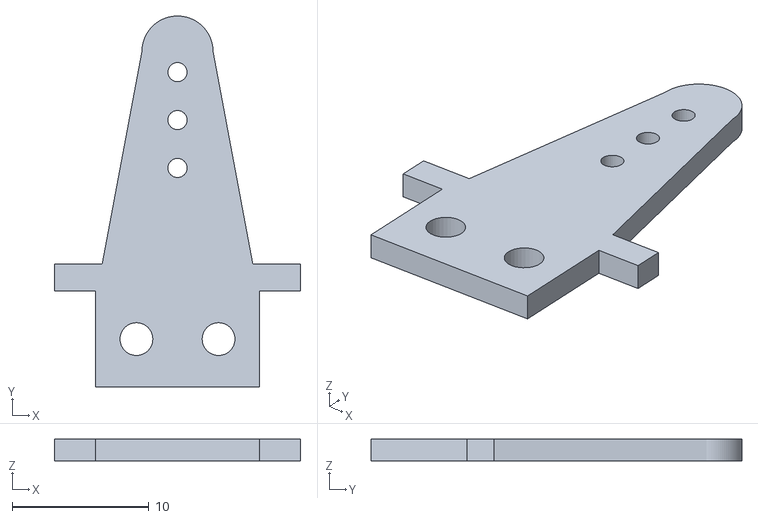
[picture p45: CAD file, 2026-10-25]
pkg/02_Print/D1b_Rev1_D1-03_Control-Horn_print-3x.stl
18.0 x 27.1 x 1.60
