schattenstrategie-collab/meridron-catalog-demo/pkg/03_Wiring/D1b_Rev1_Wiring.pdf

# D1b · WIRING

Power path thick · servo leads: brown = −, red = +, orange = signal

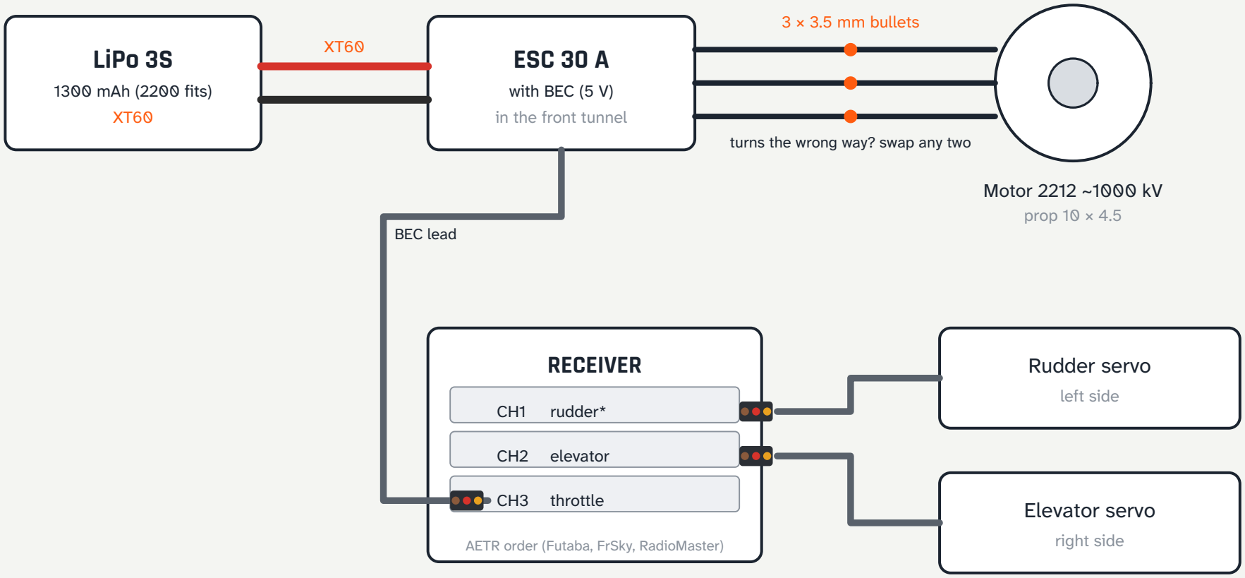
[picture p46: figure]
LiPo 3S; 1300 mAh (2200 fits) XT60; ESC 30 A; with BEC (5 V) in the front tunnel; Motor 2212 ~1000 kV prop 10 × 4.5; 3 × 3.5 mm bullets; turns the wrong way? swap any two; RECEIVER; rudder*; CH2 elevator; CH3 throttle; AETR order (Futaba, FrSky, RadioMaster); BEC lead; Rudder servo; left side; Elevator servo; right side

plug: brown/black = − red = + orange/white = S (signal) * Rudder on the aileron channel = steer with the right stick (recommended for a 3-channel trainer).
Spektrum (TAER): throttle CH1, rudder* CH2, elevator CH3. Plug the battery in last; propeller off on the bench.
Meridron · D1b Trainer Rev 1 · 25 Oct 2026 · Wiring | 1
