schattenstrategie-collab/meridron-catalog-demo/pkg/04_Firmware_Radio/D1b_Rev1_Radio_Setup.pdf

## MERIDRON · D1b TRAINER · REV 1

# FIRMWARE & RADIO SETUP

The D1b has no flight controller, so there is no firmware to flash. Everything happens in your transmitter. Do it with the propeller OFF.

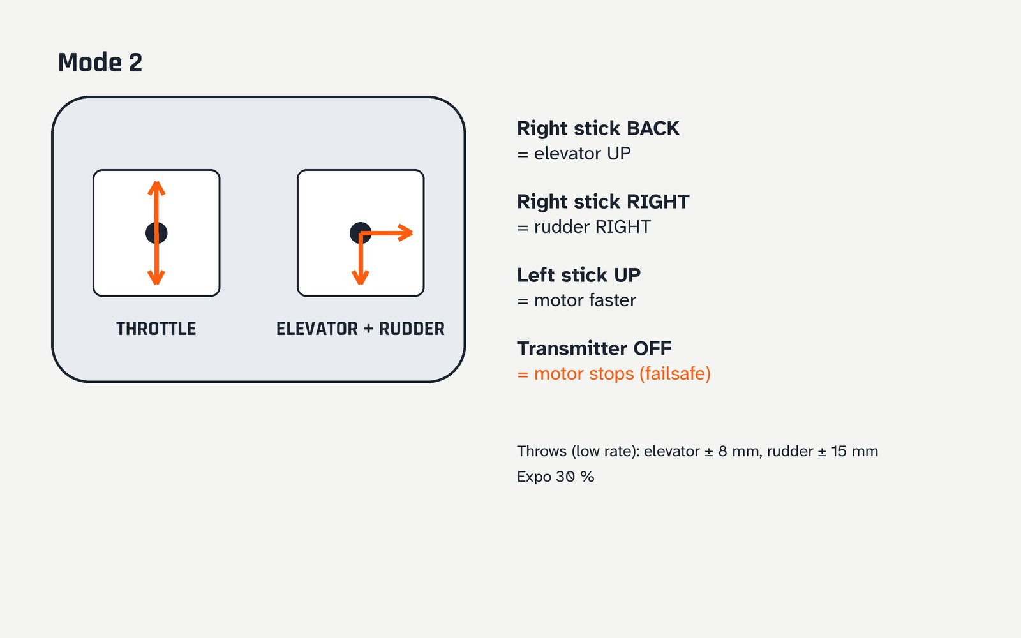
[picture p47: figure]

## 1 CHANNELS

Function | Plug in | Stick (Mode 2) | AETR* | Spektrum
Throttle | ESC | Left stick up/down | CH3 | CH1
Elevator | Servo right side | Right stick up/down | CH2 | CH3
Rudder | Servo left side | Right stick left/right (aileron channel) | CH1 | CH2

* AETR = Futaba, FrSky, RadioMaster, Jumper. Rudder sits on the aileron channel so you steer with the right stick. If your radio lets you choose, you can also use CH4 and steer with the left stick.

## 2 THROWS AND EXPO

Surface | Low rate (first flights) | High rate | Measured
Elevator | ± 8 mm | ± 12 mm | at the trailing edge next to the fuselage
Rudder | ± 15 mm | ± 25 mm | at the trailing edge, bottom

Expo: 30 % on elevator and rudder.

## 3 FAILSAFE, ESC, TIMER

- Failsafe: Throttle 0 (motor off), surfaces neutral. Test: transmitter off, the motor must stop within 1 second.
- ESC: Calibrate the throttle range as the ESC manual says.
- ESC: Brake off. Low-voltage cut-off on (3.2 V per cell).
- Timer: 8 min for the first flights. Land, then check the battery: rest voltage ≥ 3.7 V per cell.
Meridron · D1b Trainer Rev 1 · 25 Oct 2026 · Firmware & radio | 1
