schattenstrategie-collab/meridron-catalog-demo/media/s01_print.webp

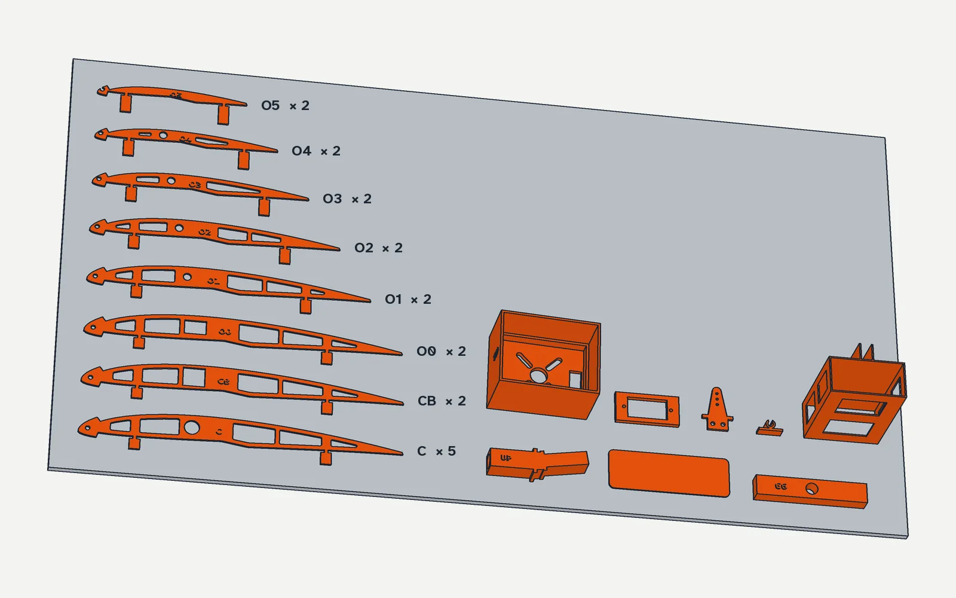
media/s01_print.webp
